Sk-mcr/SolarTracker/README.md

# SolarTracker
Mechanik that allows a phptovoltaic panel to follow the sun
