Sk-mcr/SolarTracker/3D Druckvorlagen/Deckel_Encoder.stl

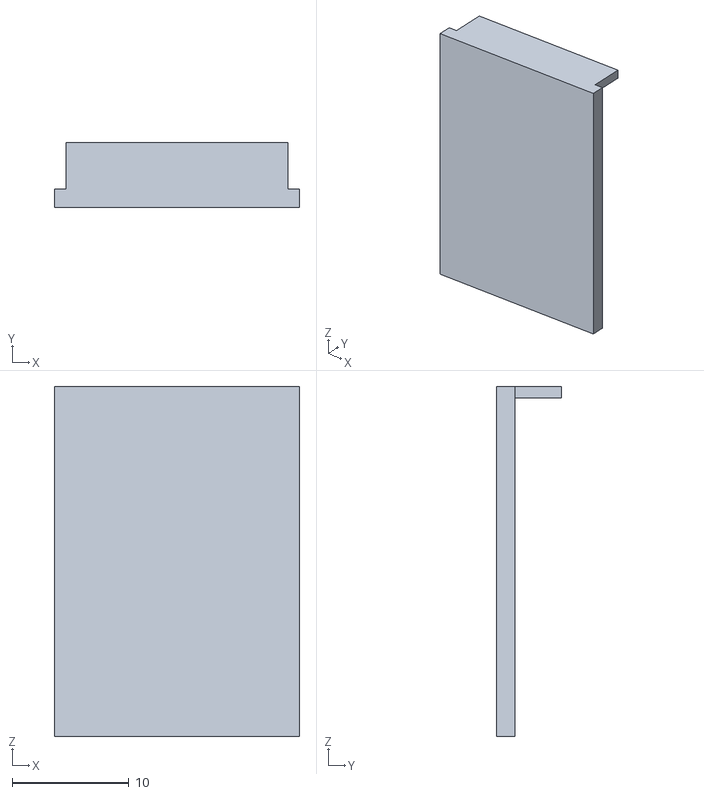
[picture p31: CAD file, 2021-04-25]
3D Druckvorlagen/Deckel_Encoder.stl
21.0 x 5.60 x 30.0
