Sk-mcr/SolarTracker/3D Druckvorlagen/MotorGelenk.stl

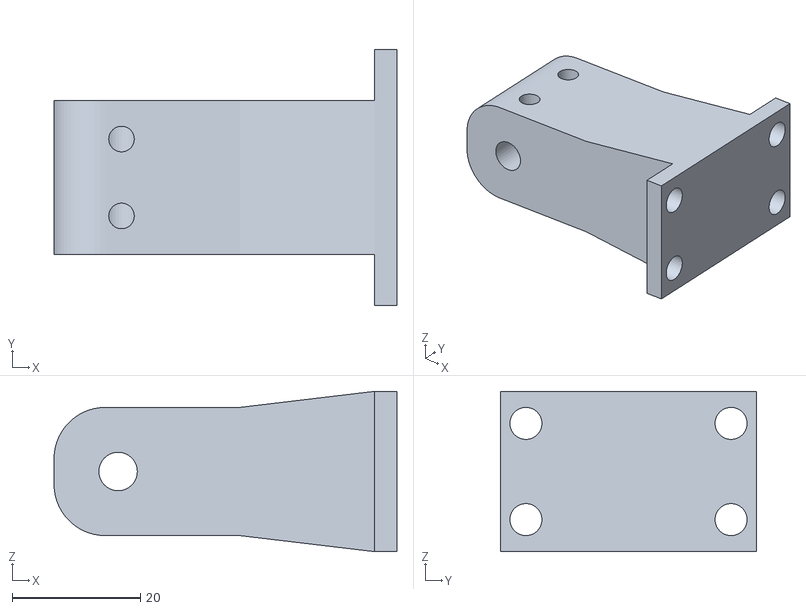
[picture p32: CAD file, 2021-04-25]
3D Druckvorlagen/MotorGelenk.stl
53.5 x 40.0 x 25.0
