Sk-mcr/SolarTracker/3D Druckvorlagen/Case_encoder.stl

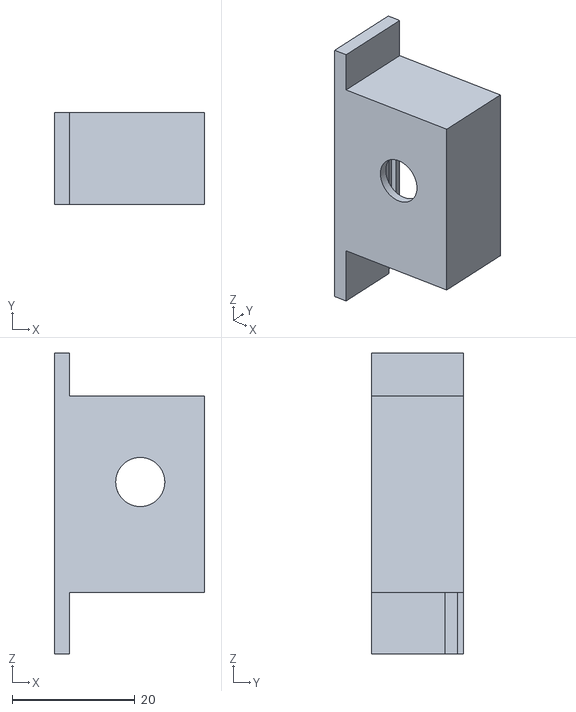
[picture p33: CAD file, 2021-04-25]
3D Druckvorlagen/Case_encoder.stl
24.5 x 15.0 x 49.0
