Sk-mcr/SolarTracker/3D Druckvorlagen/Gelenkoben.stl

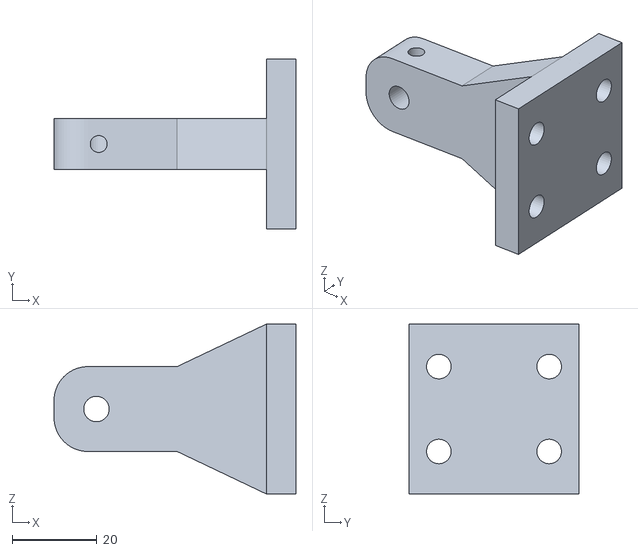
[picture p34: CAD file, 2021-04-25]
3D Druckvorlagen/Gelenkoben.stl
57.0 x 40.0 x 40.0
