Sk-mcr/SolarTracker/3D Druckvorlagen/box2_0.stl

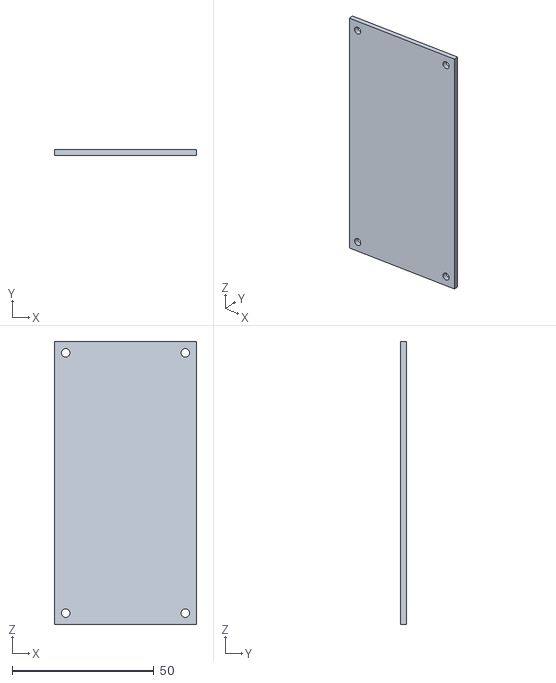
[picture p35: CAD file, 2021-04-25]
3D Druckvorlagen/box2_0.stl
50.2 x 2.00 x 99.8
