Sk-mcr/SolarTracker/3D Druckvorlagen/KupplungServo.stl

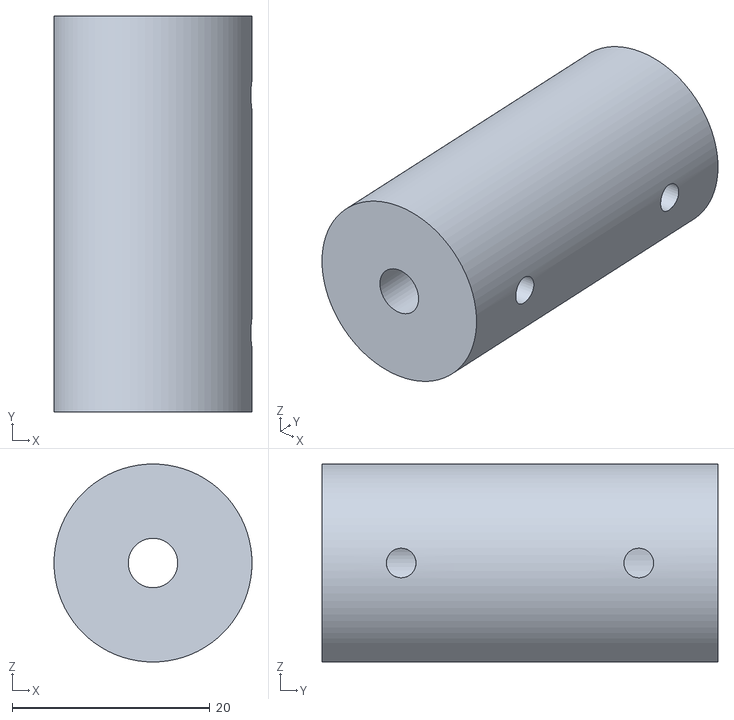
[picture p36: CAD file, 2021-04-25]
3D Druckvorlagen/KupplungServo.stl
20.0 x 40.0 x 20.0
