Sk-mcr/SolarTracker/3D Druckvorlagen/Gelenkbasis.stl

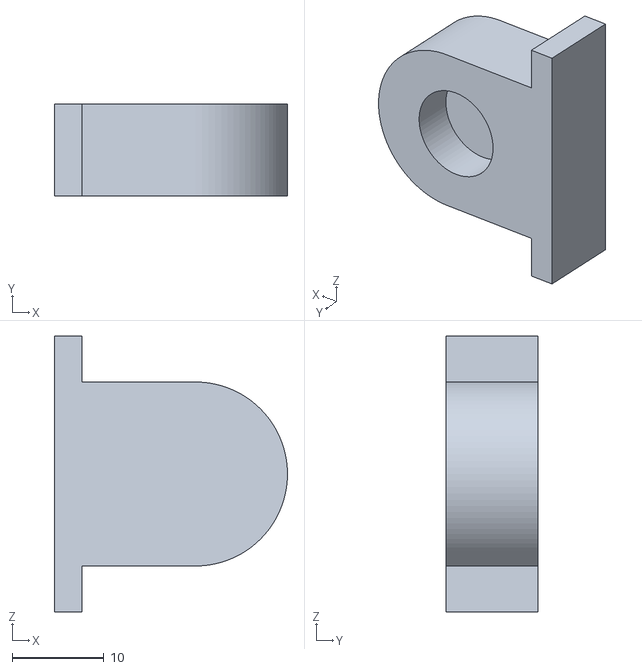
[picture p37: CAD file, 2021-04-25]
3D Druckvorlagen/Gelenkbasis.stl
25.3 x 10.0 x 30.0
