Sk-mcr/SolarTracker/3D Druckvorlagen/rand.stl

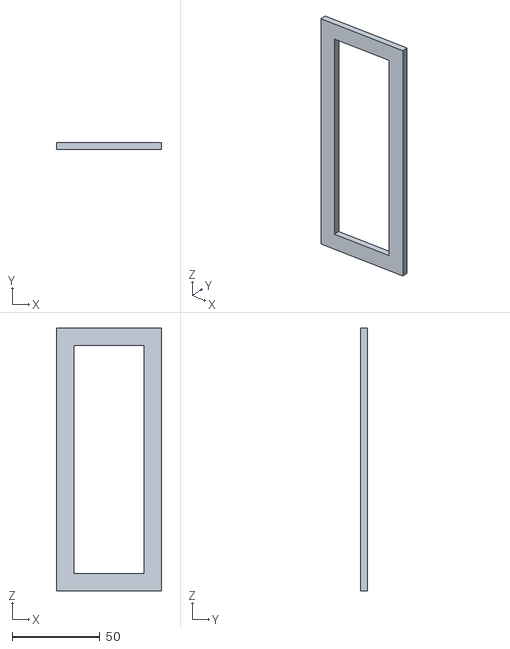
[picture p38: CAD file, 2021-04-25]
3D Druckvorlagen/rand.stl
60.0 x 4.00 x 150.0
