Sk-mcr/SolarTracker/3D Druckvorlagen/box3.stl

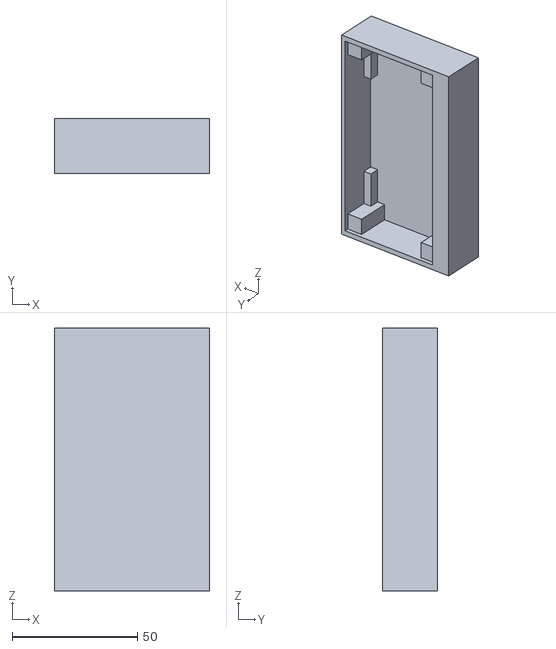
[picture p39: CAD file, 2021-04-25]
3D Druckvorlagen/box3.stl
62.0 x 22.0 x 105.0
