Sk-mcr/SolarTracker/3D Druckvorlagen/schattenmatrix.stl

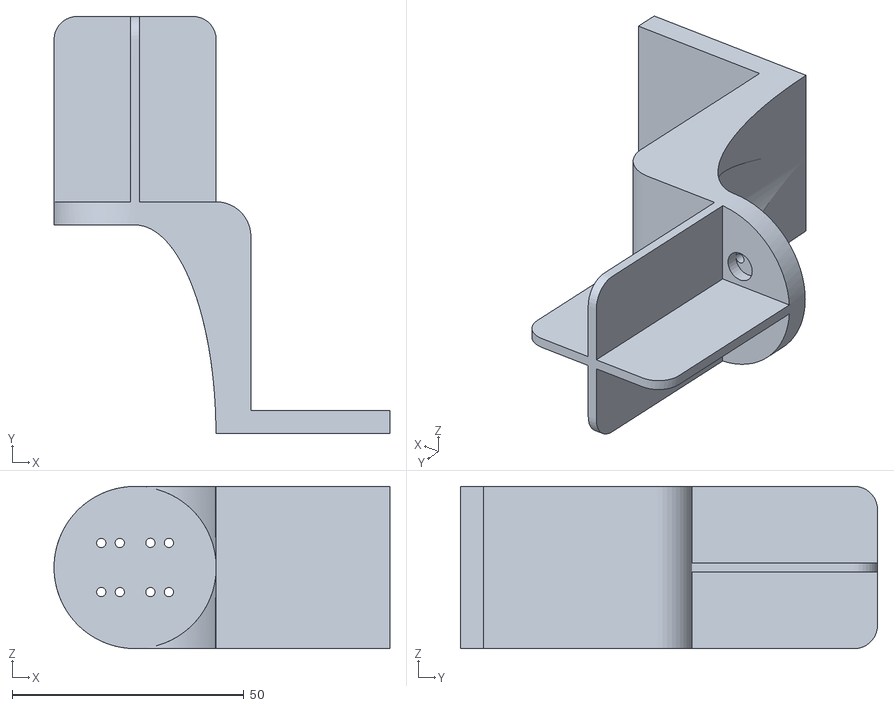
[picture p40: CAD file, 2021-04-25]
3D Druckvorlagen/schattenmatrix.stl
72.5 x 90.0 x 35.0
