Sk-mcr/SolarTracker/Datenblätter/schattenmatrix.pdf

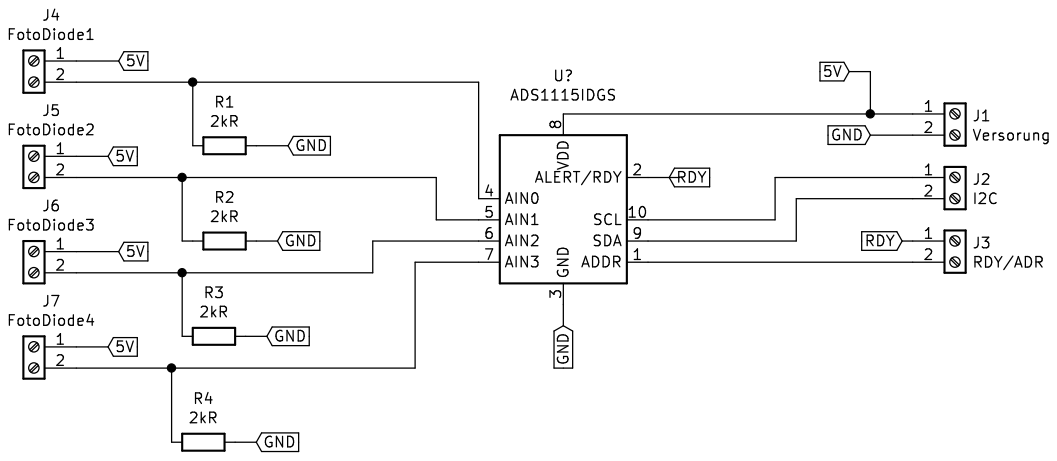
[picture p41: page 1]
