Sk-mcr/SolarTracker/Datenblätter/stromlaufplan.pdf

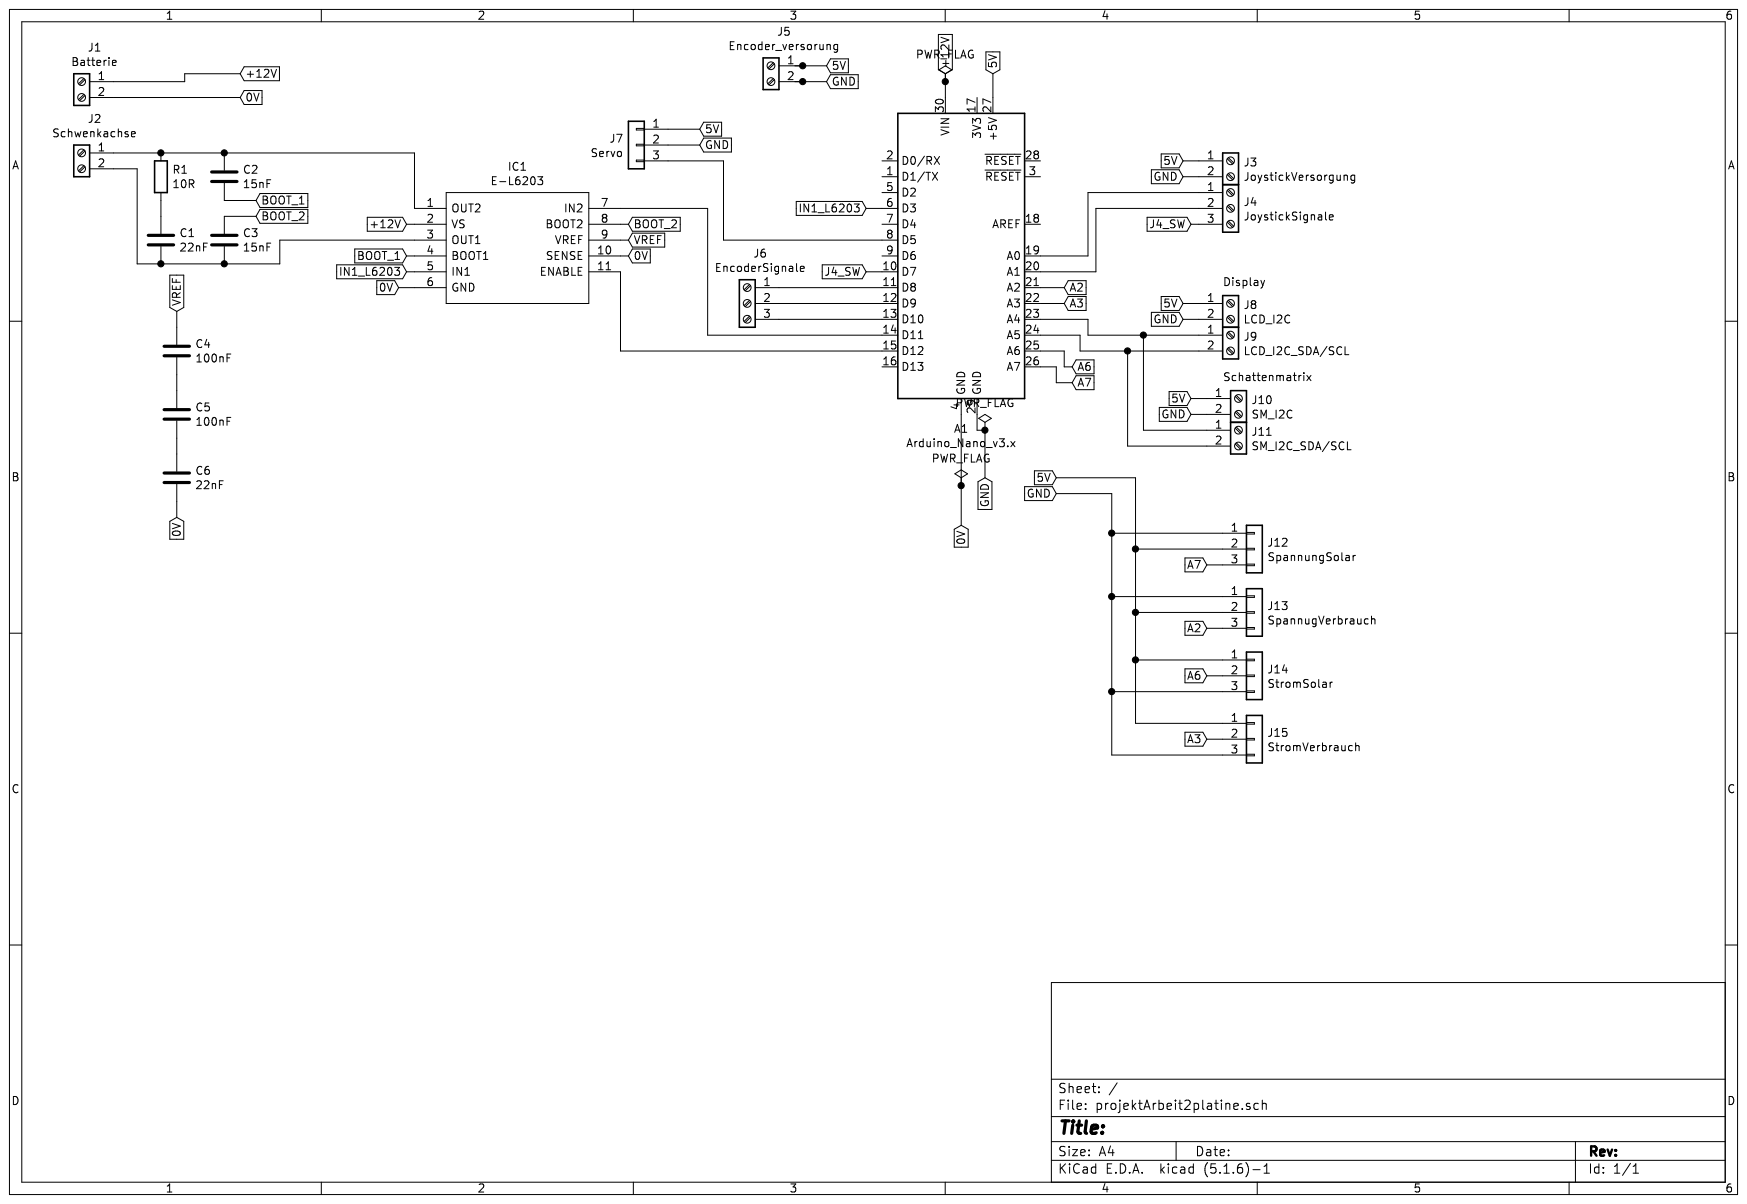
[picture p42: page 1]
